jerryhanson/frontiers/README.md

# frontier
Step by step instruction file
3D printing file (sla material and pla material)
