jerryhanson/frontiers/Instrcuturtion(seeAnnotation).pptx

Sound attenuated training box: Acrylic plastic framework

## Slide 2

a

b

35

25

25

Hinge door

35

6

punching

Circle diameter 5mm

5

25

Horizontal gap, 5 mm width and 15 cm length

25

25

c

d

35

25

15

Horizontal gap, 5 mm width and 15 cm length

Notes: Acrylic plastic outer training box
Unit by centimeter, not including plate thickness
a) Stereo view
b) Right side view
c) Back side view
d) Upper side view

## Slide 3

a

c

1

1

25

1

1

Punching
Hole diameter 5 mm

15

1

1

1

1

Horizontal gap, 5 mm width and 10 cm length

15

15

Horizontal gap, 5 mm width and 10 cm length

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
Punching

25

6

15

e

Notes: Acrylic plastic inner training box
Unit by centimeter, not including plate thickness
A) Stereo view, Five –side box, no plate in front side
c) Bottom view
d) Right side view
b) Back side view
E) Upper side view

## Slide 4

1

25

1

4

1

Punching
Hole diameter 5 mm

1

Punching
Rectangle size 2 cm by 1 cm

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
Notes: Acrylic plastic plate, thickness is 5 mm
Unit by centimeter

## Slide 5

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
孔直径5mm

5

25

切割缝, 5 mm 宽，15 cm 长

25

25

c

d

35

25

15

切割缝, 5 mm 宽，15 cm 长

Notes: Acrylic plastic outer training box
Unit by centimeter, not including plate thickness
a) Stereo view
b) Right side view
c) Back side view
d) Upper side view

## Slide 6

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
孔直径 5 mm

15

1

1

1

1

切割缝, 5 mm 宽，10 cm 长

15

15

切割缝, 5 mm 宽，10 cm 长

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
Notes: Acrylic plastic inner training box
Unit by centimeter, not including plate thickness
A) Stereo view, Five –side box, no plate in front side
c) Bottom view
d) Right side view
b) Back side view
E) Upper side view

## Slide 7

1

25

1

4

1

打孔
孔直径 5 mm

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
矩形尺寸2 cm x 1 cm

0.5

1

1

Notes: Acrylic plastic plate, thickness is 5 mm
Unit by centimeter

## Slide 8

Sound attenuated training box: ventilator, foam, support

## Slide 9

a

b

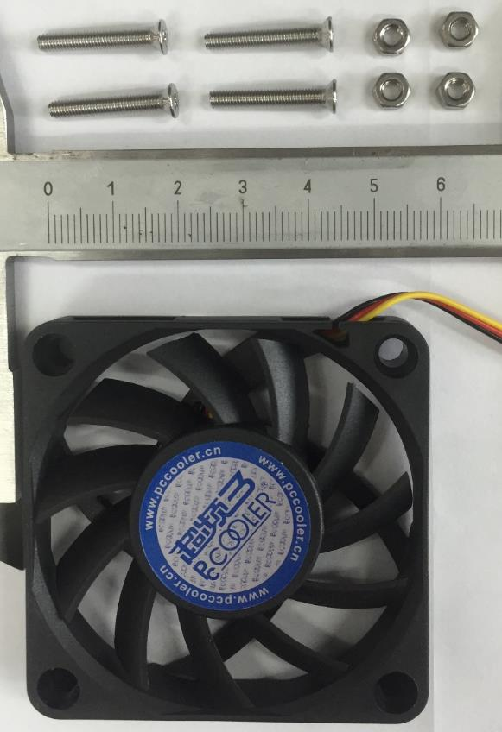
[picture p1: figure]
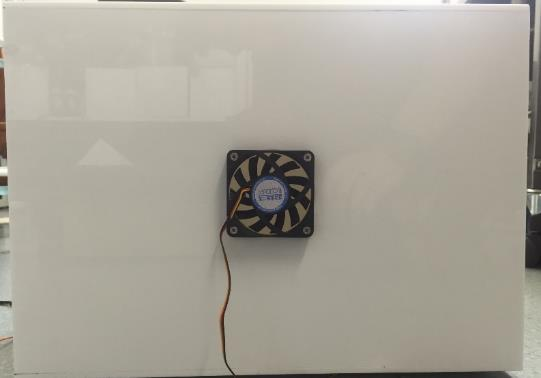
[picture p2: figure]
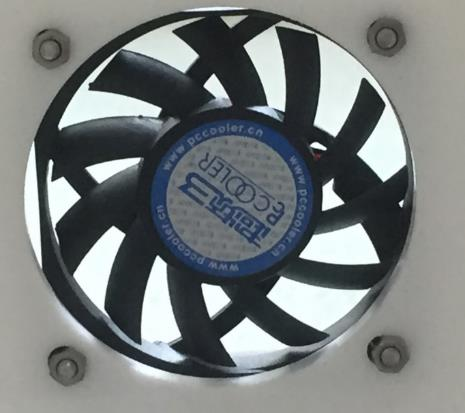
[picture p3: figure]

c

Notes: Install a ventilation fan
Needed ventilation fan and four sets of screw and screw cap
back side view of outer training box after installing a ventilation fan
inside view of outer training box after installing a ventilation fan

## Slide 10

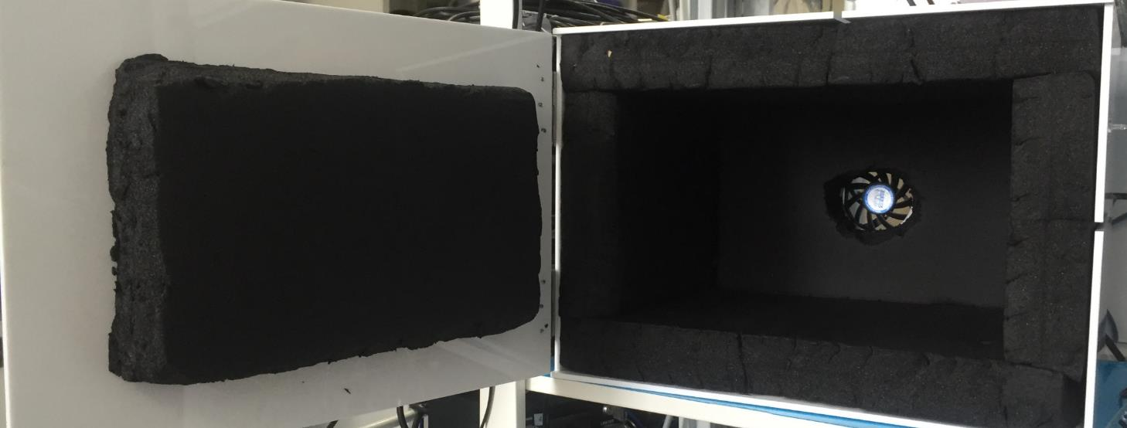
[picture p4: figure]

Notes: Attach sound insulation sponge. Insulation sponge thickness is 45 mm.

## Slide 11

a

b

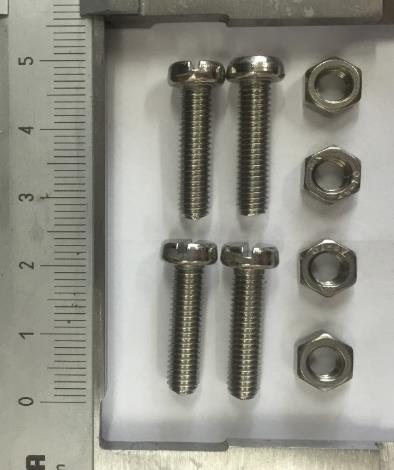
[picture p5: figure]
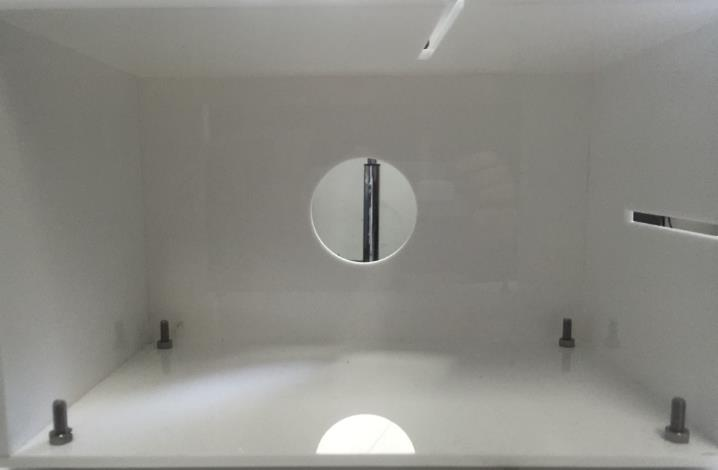
[picture p6: figure]

Notes: Install screw and screw cap to acrylic plastic plate.
Needed four sets of screw and screw cap
inside view of inner training box after installing screws and screw caps

## Slide 12

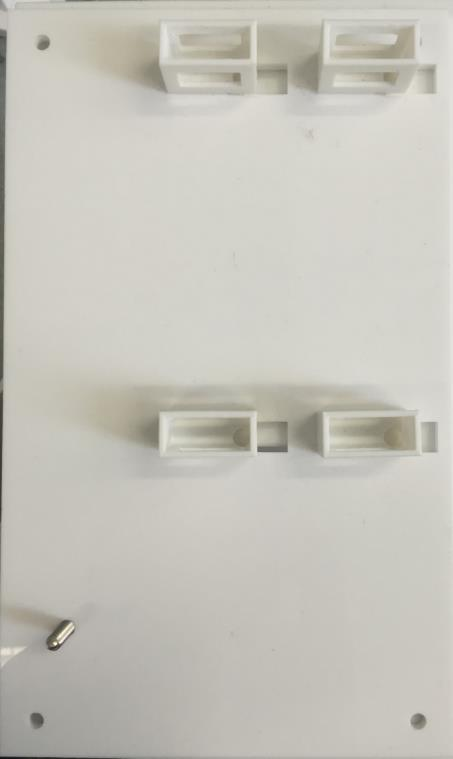
[picture p7: figure]

Notes: Attach one screw and four sliding brackets to acrylic plastic plate

## Slide 13

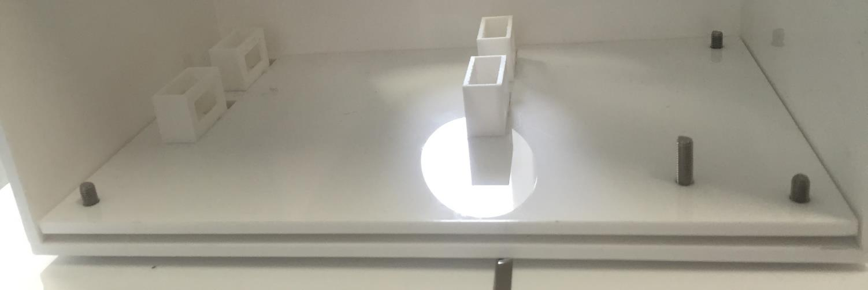
[picture p8: figure]

Notes: Place acrylic plastic board to inner training box.

## Slide 14

a

b

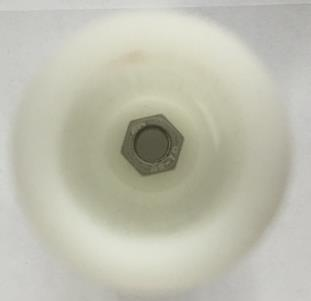
[picture p9: figure]

d

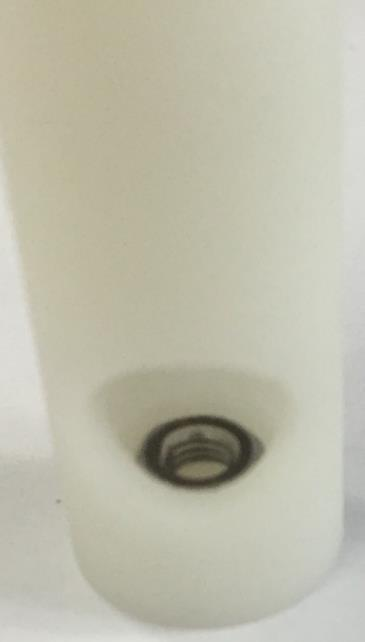
[picture p10: figure]
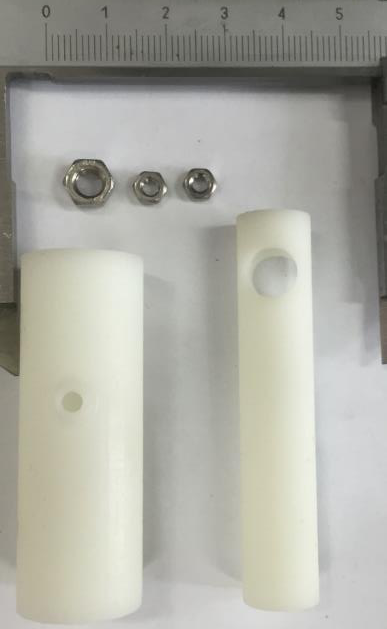
[picture p11: figure]

c

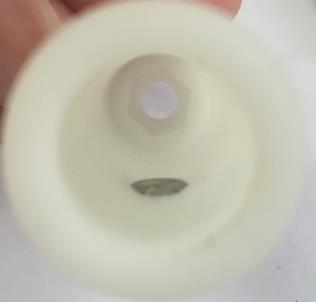
[picture p12: figure]

Notes: Install a holder
Needed three screws and two parts of holder (outer and inner)
install one screw to the inside bottom of outer holder
Install one screw to the inside surface of outer holder
install one screw to the inside upper side of inner holder

## Slide 15

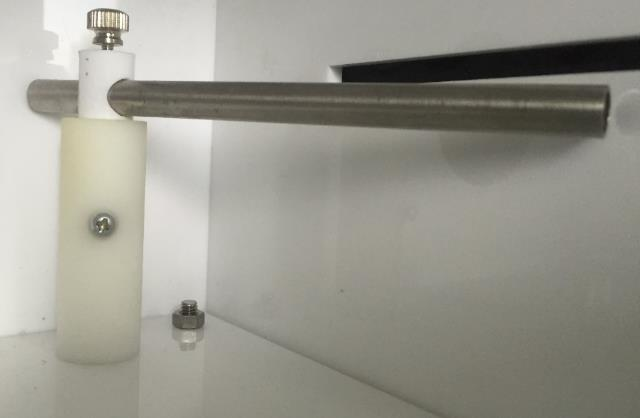
[picture p13: figure]

Notes: Install holder to acrylic plastic board

## Slide 16

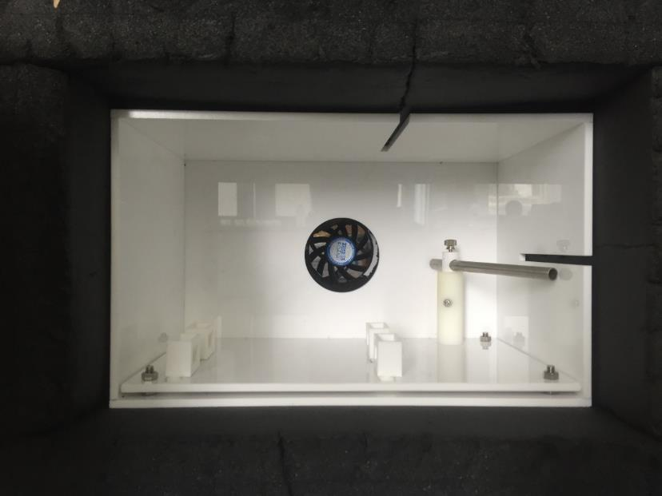
[picture p14: figure]

Notes: Insert inner training box into outer training box .

## Slide 17

Training tube

## Slide 18

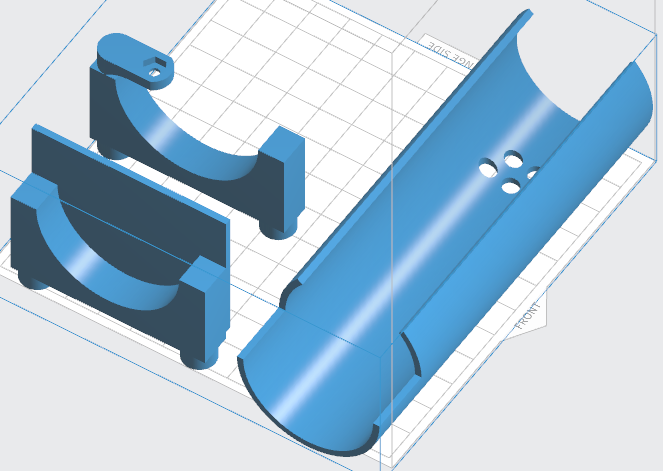
[picture p15: figure]

a

c

b

Notes: Three-dimensional blue print of training tube.
Front part of training tube
Back part of training tube
Training tube

## Slide 19

a

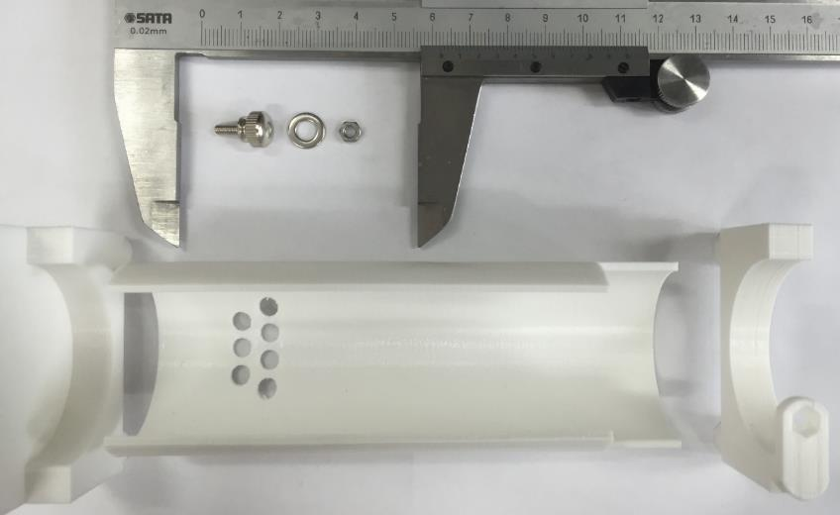
[picture p16: figure]

b

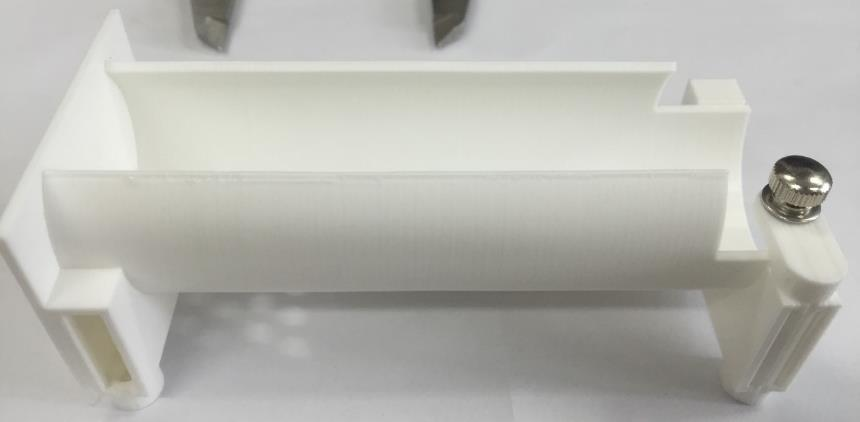
[picture p17: figure]

Notes: Assemble a training tube
Needed screw, screw cap, screw plate and three parts of training tube
attach three parts of training tube, install screw, screw plate and screw cap.

## Slide 20

Motorized water port, odor tube socket

## Slide 21

a

b

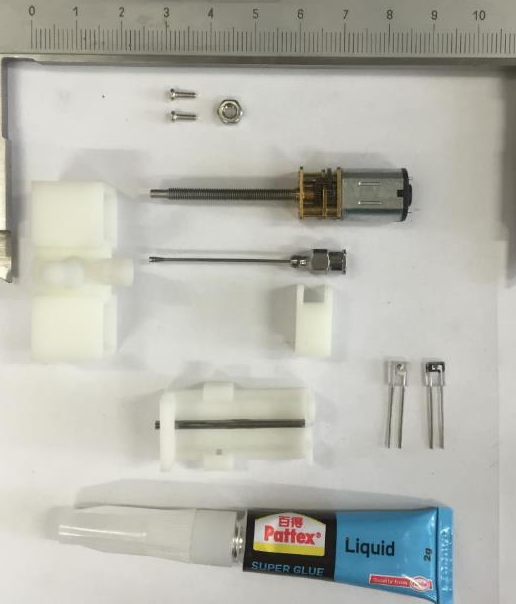
[picture p18: figure]

d

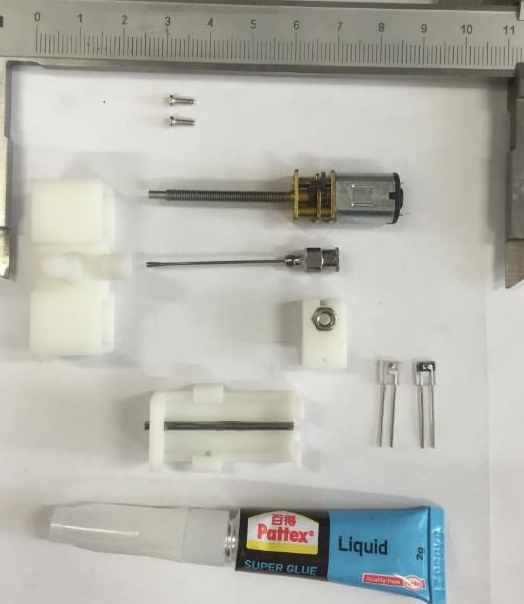
[picture p19: figure]
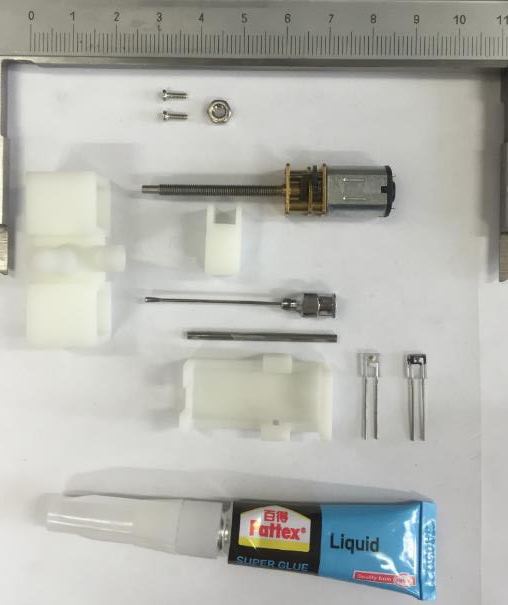
[picture p20: figure]

a

c

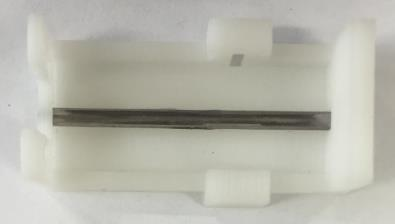
[picture p21: figure]

e

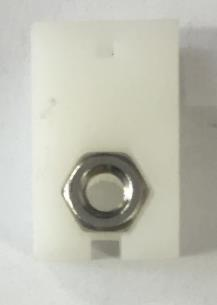
[picture p22: figure]

Notes: Assemble a movable water port
Needed three printed parts of water port, DC motor. Intra gastric needle, iron bar, super glue, two screws, one screw cap and a pair of IR diode
c) insert iron bar into sliding pad
d) e)Insert screw into slide block

## Slide 22

a

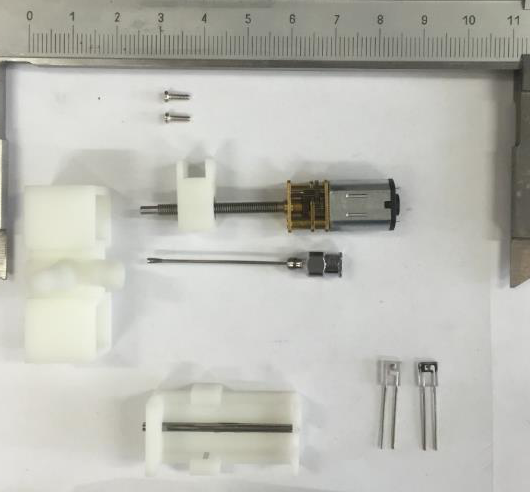
[picture p23: figure]

c

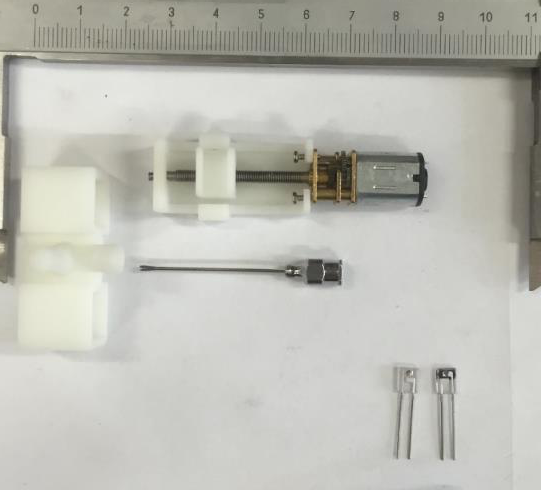
[picture p24: figure]
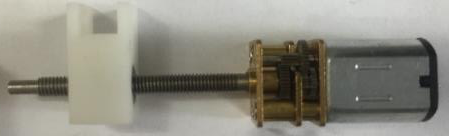
[picture p25: figure]
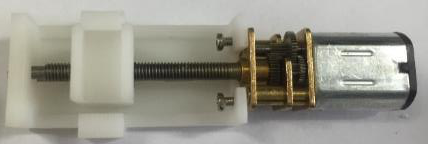
[picture p26: figure]

b

d

Notes: b) Screw the DC motor into sliding block
c) d) assemble sliding pad and sliding block

## Slide 23

a

b

c

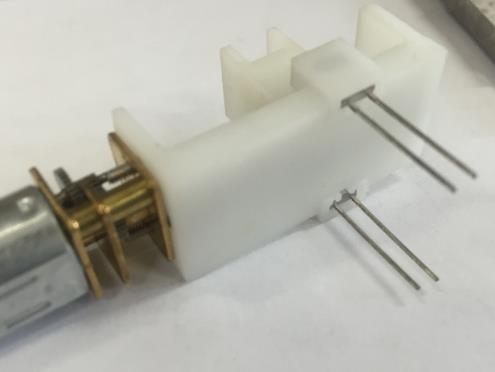
[picture p27: figure]
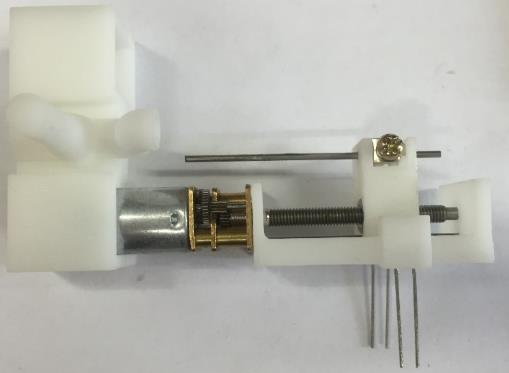
[picture p28: figure]
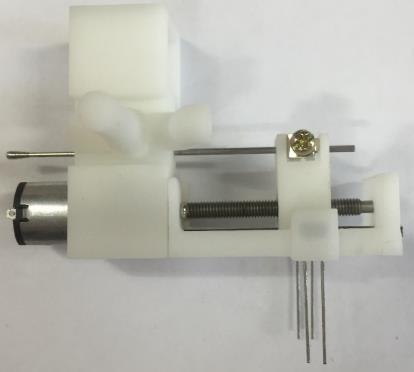
[picture p29: figure]

Notes: Insert IR diodes into bracket of sliding pad
c) Insert intra gastric needle into holes of sliding block, and insert DC motor into motor bracket.

## Slide 24

Odor delivery part

## Slide 25

PUMP

FILTER

V

M

M

M

V

M

Two-way manual valve

Three-way solenoid valve

Manual air flow controller

FLOW METER

MOUSE

V

V

V

V

V

V

Odorant bottle

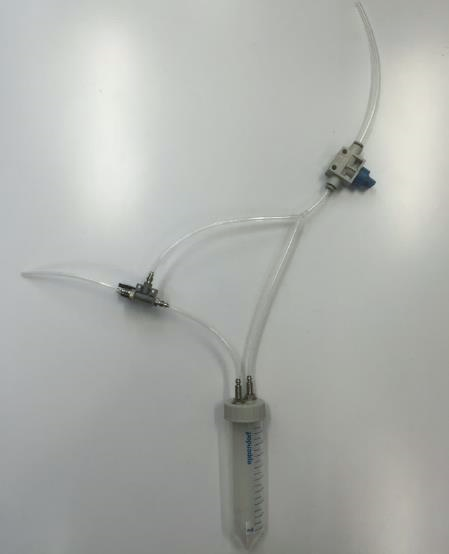
[picture p30: figure]

15cm

15cm

5cm

10cm

15cm

10cm
