jerryhanson/frontiers/pla/tube2.STL

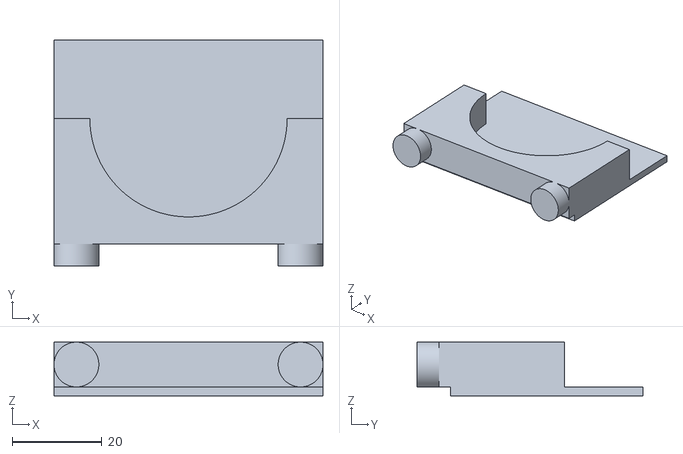
[picture p31: CAD file, 2017-11-08]
pla/tube2.STL
60.0 x 50.5 x 12.0
