jerryhanson/frontiers/sla/odorTubeSocket.STL

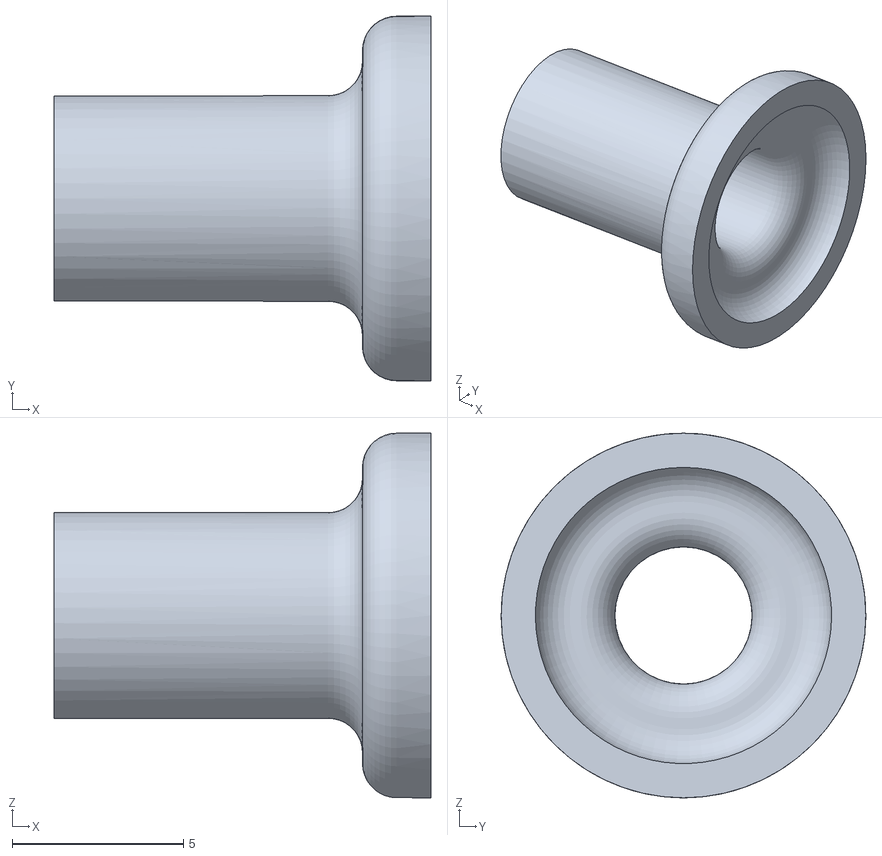
[picture p32: CAD file, 2017-11-08]
sla/odorTubeSocket.STL
11.0 x 10.6 x 10.6
