jerryhanson/frontiers/pla/tubeSocket.STL

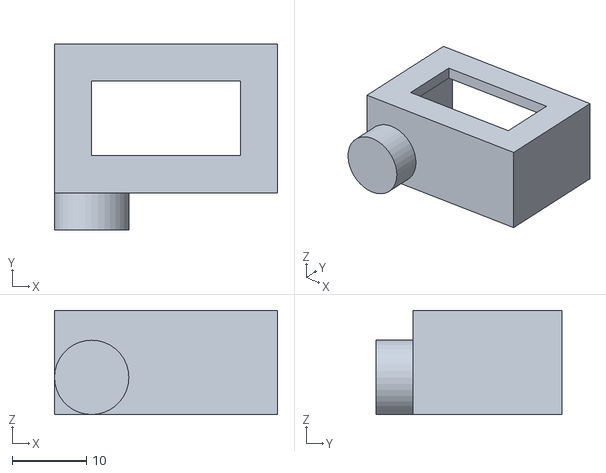
[picture p33: CAD file, 2017-11-08]
pla/tubeSocket.STL
30.0 x 25.0 x 14.0
