jerryhanson/frontiers/pla/tube.stl

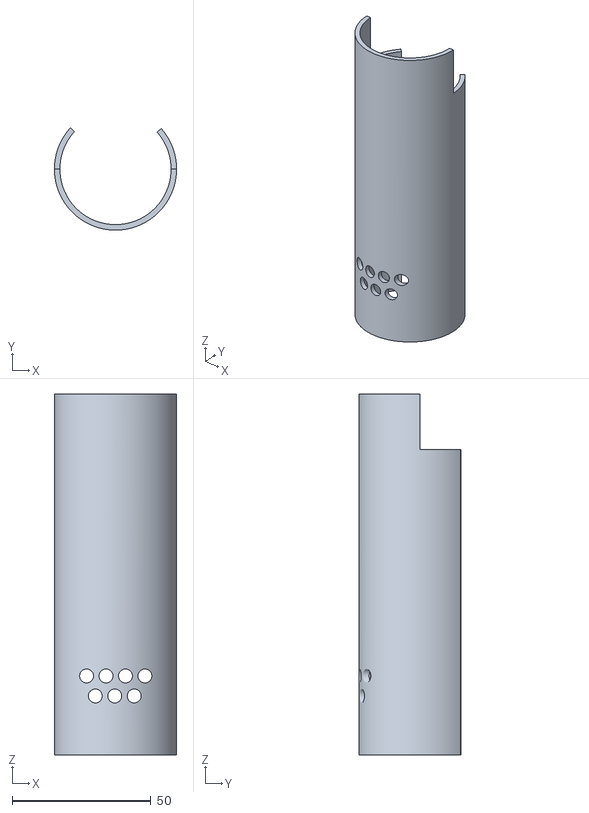
[picture p34: CAD file, 2017-11-08]
pla/tube.stl
44.0 x 36.8 x 130.0
