jerryhanson/frontiers/sla/mixChamber.STL

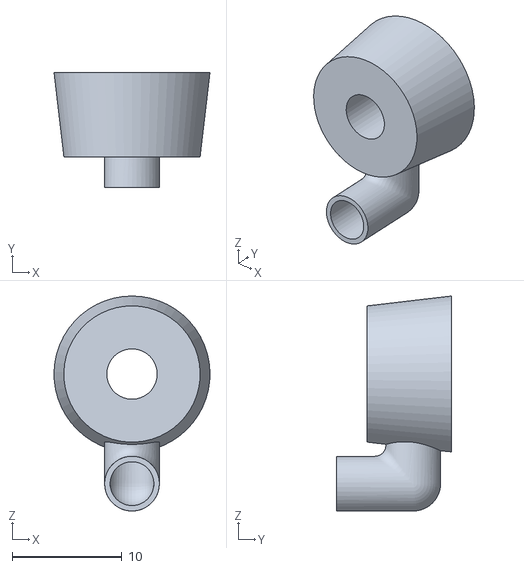
[picture p35: CAD file, 2017-11-08]
sla/mixChamber.STL
14.2 x 10.5 x 19.6
