jerryhanson/frontiers/pla/holder.STL

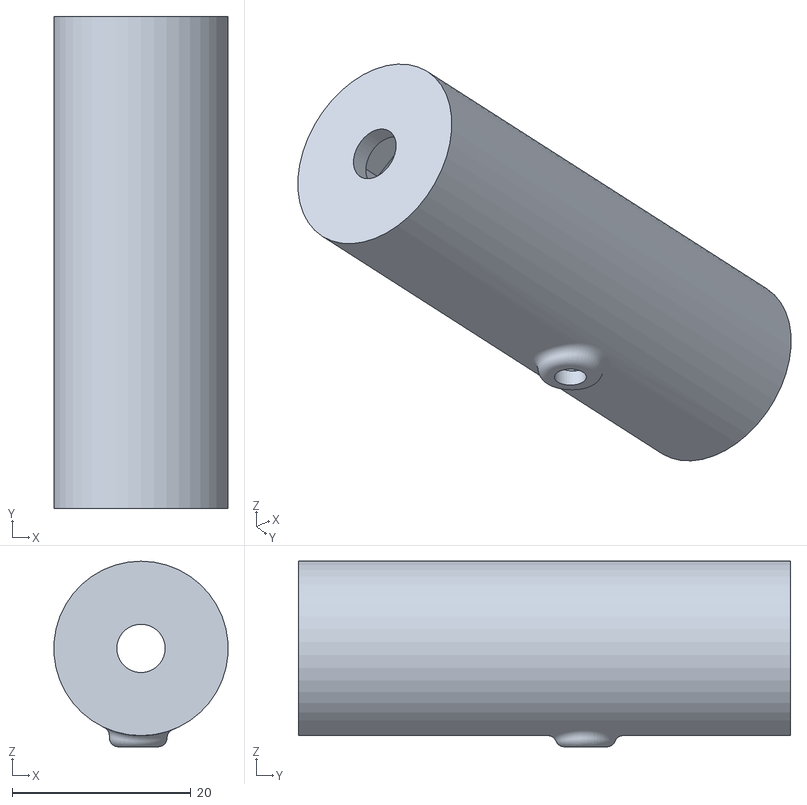
[picture p36: CAD file, 2017-11-08]
pla/holder.STL
19.4 x 55.0 x 20.8
