jerryhanson/frontiers/sla/pad.STL

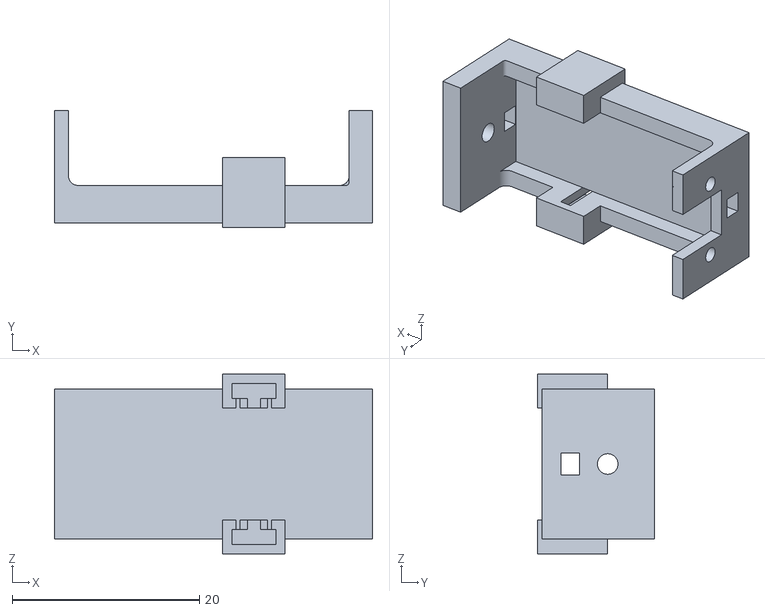
[picture p37: CAD file, 2017-11-08]
sla/pad.STL
34.0 x 12.5 x 19.2
