jerryhanson/frontiers/pla/tube3.STL

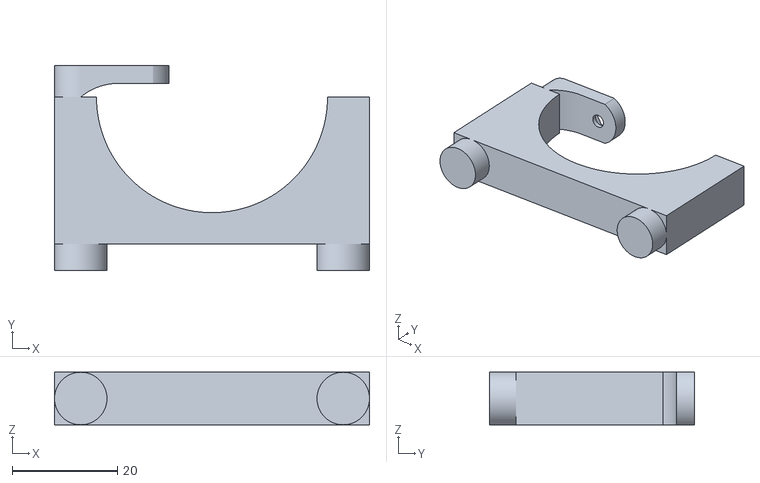
[picture p38: CAD file, 2017-11-08]
pla/tube3.STL
60.0 x 39.0 x 10.0
