jerryhanson/frontiers/sla/holder2.STL

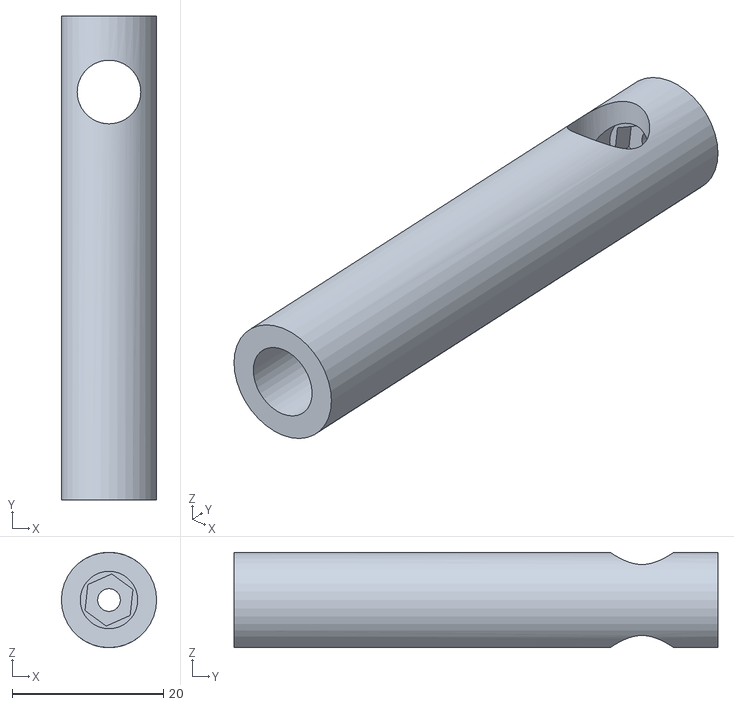
[picture p39: CAD file, 2017-11-08]
sla/holder2.STL
12.6 x 64.0 x 12.6
