jerryhanson/frontiers/sla/screw.STL

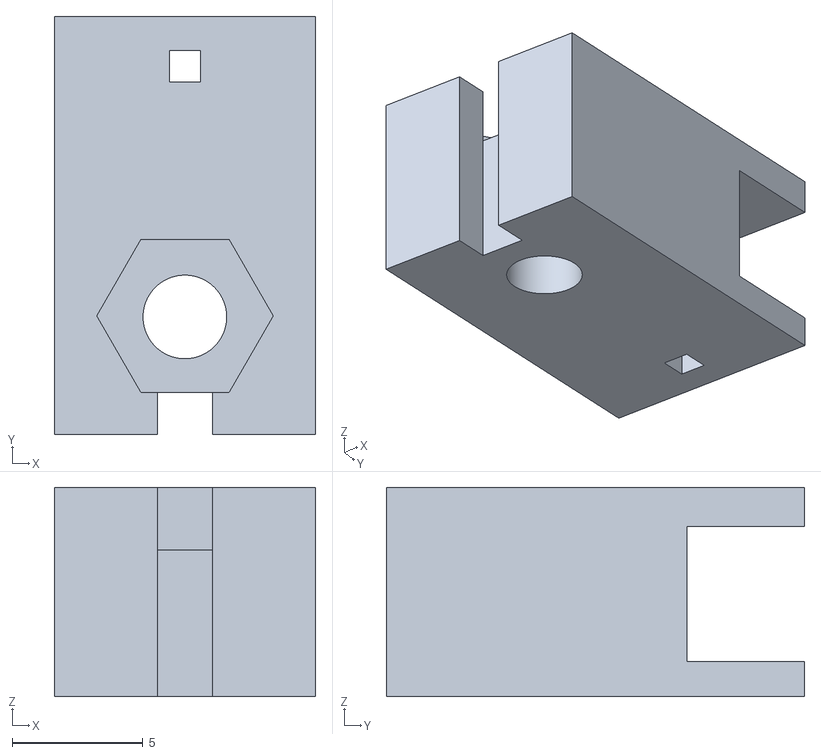
[picture p40: CAD file, 2017-11-08]
sla/screw.STL
10.0 x 16.0 x 8.00
